azmainadel/4bit-pc/README.md

# SAP 4 bit PC
CSE404 Sessional Assignment

### Project members:
* [Azmain Adel](https://github.com/azmainadel/)
* [Maksudul Alam](https://github.com/Maksudul087/)
* [Muhtasim Ulfat](https://github.com/MuhtasimTanmoy/)
* Sadman Yasar
* Sazzad Hossain
