azmainadel/4bit-pc/(list of files, drawings)

Other design files:
B1_G5/4bitpc.pdsprj
